bit-trade-one/REVIVE-USB/README.md

# AD00007-REVIVE-USB

## オリジナルUSBデバイスを簡単に作成できるREVIVE USB  
  

USBでパソコンと接続し、専用ソフトウェアを用いて12本のピンに  
任意の操作（マウスクリック／キー入力等）を設定する事が出来ます。 

## [製品の詳細はこちら(BTO_HP)](http://bit-trade-one.co.jp/product/assemblydisk/revive-usb/)

## [キット版組み立て説明書](https://github.com/bit-trade-one/REVIVE-USB/blob/master/Manual/Revive_manual.pdf)  

## [アプリケーションソフト](https://github.com/bit-trade-one/REVIVE-USB/raw/master/App/)  

## [ファームウェア](https://github.com/bit-trade-one/REVIVE-USB/raw/master/FirmWare/)

## [Q&A](https://github.com/bit-trade-one/REVIVE-USB/blob/master/FAQ.md)

### [アプリケーションソース](https://github.com/bit-trade-one/REVIVE-USB/raw/master/App_source/)  

### [ファームウェアソース](https://github.com/bit-trade-one/REVIVE-USB/raw/master/Firmware_source/)

### [基板図](https://github.com/bit-trade-one/REVIVE-USB/blob/master/Dimensions/AD00007_REVIVE_USB_dimensions.pdf)

### [回路図](https://github.com/bit-trade-one/REVIVE-USB/blob/master/Schematics/revive_sch.png)

### [部品表](https://github.com/bit-trade-one/REVIVE-USB/blob/master/Partslist/AD00007-PartsList.md)

## 作例

[\[Bit-trade-one公式\] / 「REVIVE USBを使ってジョイスティックを作成しました！」](http://bit-trade-one-blog.blogspot.com/2012/01/revive-usb.html)  
[\[Bit-trade-one公式\] / 「REVIVE USBを用いたテンキーのショートカットキーボード化」](https://docs.google.com/document/pub?id=1tj2YW0OkGKYTroH0v_psLJJ5uBwOZKFZ7izL9BA2TJg)  
[「味わい尽くせ！ 」様 / 「REVIVE USBをアナログXY軸に対応してみた」](https://gurochoro.blogspot.com/2017/01/revive-usb-infinitas.html)  
[「SEGA至上主義」様 / 「JTKのnProエラーでお困りの方に多ボタンコントローラー自作のススメ」](http://blog.livedoor.jp/sega_ss/archives/12361631.html)  

## 掲載情報

[4Gamer様/「GPUやドライバ，ディスプレイは「ゲームプレイの速度」についていけているのか？ 操作遅延計測用デバイスを開発してみた」](https://www.4gamer.net/games/999/G999902/20171225140/)

## 製品仕様

    製品名：REVIVE USB
    型番：キット版AD00007　/　組立済版　AD00007P
    サイズ：W22×D49mm
    入力点数：12(デジタル)
    コネクタ：シリーズ・ミニB
    対応OS：Windows 10 / 8.1/ 8 / 7 / Vista / XP
    JANコード：キット版　4560196900189 / 組立済版　4560196900394
