bit-trade-one/REVIVE-USB/FirmWare/Readme.md

# ファイルリスト

 - REVIVE_USB_ver008.zip(通常版)
 - REVIVE_MATRIX_ver005.zip(マトリックス版)
 - HIDBootLoader.exe(ファームウェア書込ツール)

# REVIVE USB ファームウェア

REVIVE USB MICROのファームウェアとソースコードを公開しています。  

## HIDブートローダ書き込みソフト（HIDBootLoader.exe）の使い方

### 1. このソフトで何が出来るのか

REVIVE USBはMicrochip社のPICと言うマイコンを用いて作られています。  
通常、PICマイコンにソフトを書き込む為には「ライタ」と呼ばれる書き込み装置が必要です。  
（Microchip社が出しているPICkitや、秋月電子のキットであるAKI-PICプログラマーなどが有名です）  

このソフトを用いれば、特別なライタを必要とせず、USBから直接マイコンのソフトを書き換える事ができます。  
ただし、その為にはマイコンにBootLoaderと呼ばれる特別なソフトがあらかじめ書き込まれている必要があり、またUSB経由で書き込むソフトもBootLoaderに対応したものになっていなければなりません。  
あらかじめ書き込まれるBootLoader自体は、「ライタ」で書き込まなければなりません。  

REVIVE USBに付属しているマイコンにはこのBootLoaderと言う特別なソフトがあらかじめ書かれています。よって、特別なライタをお持ちでなくてもUSB経由でソフトを書き込むことができます。  
また、Assembly Deskで公開されているREVIVE USB用のソフトはこのBootLoaderでの書き込みに対応したソフトになっています。  

このBootLoaderを使うことで、USB経由で簡単にソフトを書き換えて、REVIVE USBのソフトを様々に書き換える事ができます。  

### 2. 準備

Assembly DeskのサイトからHIDBootLoader.exeをダウンロードします。  
（これは、Microchipさんが公開しているライブラリ「MCHPFSUSB」の中にある物と同一です）  

このソフトは.NET framework 2.0を用いて作成されています。  
お手持ちのパソコンに.NET frameworkがインストールされていない場合、MicrosoftさんのHPからこれらをダウンロードし、インストールしておく必要があります。  
“Microsoft .NET framework”等のキーワードで検索すると出てきます。  

書き込みたいソフトもダウンロードしておきます。  

### 3. ソフトの書き込み

HIDBootLoader.exeを立ち上げます。  
  
次に、REVIVE USBのショートピンをBOOTに設定し、USBケーブルを接続します。  
（REVIVE USBが既に差し込んであった場合には一度抜いてからショートピンをBOOTに変更し、再度USBケーブルを差し込みます）  
  
ショートピンをBOOTの方にし、USB ケーブルを接続します。  
  
デバイスが認識されると上図の様に「Device attached」と表示されます。  
この表示が出たら「上」ボタンは離しても大丈夫です。  
始めてBOOTモードで接続した時には、自動的にPCにドライバがインストールされます。（約１分程時間かかります）  

「Open Hex File」を押します。  
書き込みたいHexファイルを選択します。  
  
「Program/Verify」を押します。  
ソフトが書き込まれます。  
  
ショートピンを通常状態に戻し、USBケーブルを抜き差しするか、「Reset Device」を押すと、書き込んだソフトが起動します。
