bit-trade-one/REVIVE-USB/Firmware_source/Readme.md

# ファイルリスト

 - ReviveUSB_FWver008.zip(通常版)
 - MatrixVer005.zip(マトリックス版)

# REVIVE USBファームウェアソースコード

このファームウェアは以下の環境で開発しています。
 - MPLAB  IDE           v8.92
 - MPLIB  Librarian     v5.00
 - MPLAB  C18 Compiler  v3.47
 - MPLINK Object Linker v5.00
 - MPASM  Assembler     v5.54
