bit-trade-one/REVIVE-USB/App_source/Readme.md

# ファイルリスト

 - ReviveUSB_CTsrc_ver130.zip(通常版)
 - PCMatrix_v111.zip(マトリックス版)
 
# REVIVE USB 設定ツール開発環境

このソフトウェアは、以下の環境で開発されています。
- Microsoft Visual C# 2010 Express
