bit-trade-one/REVIVE-USB/Schematics/revive_sch.png

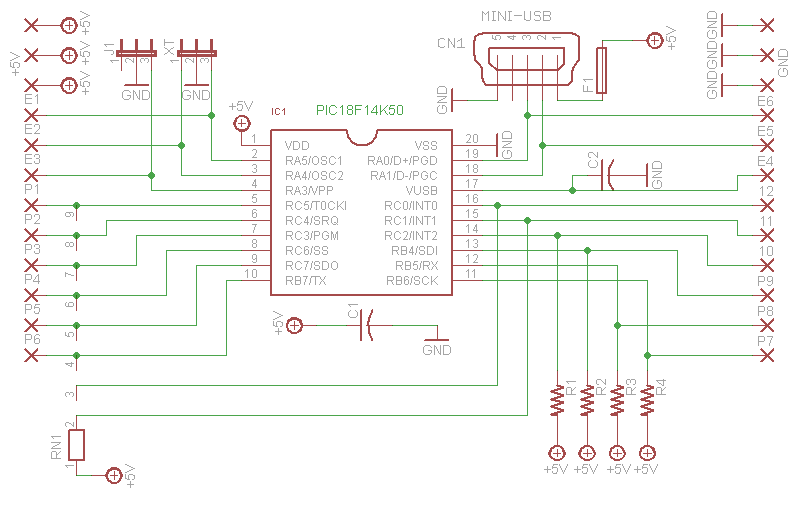
Schematics/revive_sch.png
