bit-trade-one/REVIVE-USB/Partslist/AD00007-PartsList.md

|記号|品名|型式|値|備考|
|:-|:-|:-|:-|:-|
|C1|セラミックコンデンサ||0.1uF|104と印字|
|C2|セラミックコンデンサ||0.1uF|104と印字|
|CN1|USB コネクタ|||ミニB|
|R1|抵抗||1kΩ|茶 黒 赤 金|
|R2|抵抗||1kΩ|茶 黒 赤 金|
|R3|抵抗||1kΩ|茶 黒 赤 金|
|R4|抵抗||1kΩ|茶 黒 赤 金|
|RN1|集合抵抗|RKL8BD-102J|1kΩ|向きに注意|
|X1|セラミック発振子||12MHz||
|F1|ポリスイッチ|RXEF017|0.17A||
|IC1|ICソケット||20ピン|向きに注意|
|IC1|マイコン|PIC18F14K50||向きに注意|
||基板||||
||ヘッダピン||12ピン|2ヶ|
||ヘッダピン||3ピン||
||ショートピン||||
||貼付けボス|ASR-6||2ヶ|
||タッピングネジ|3×6||2ヶ|
