bit-trade-one/REVIVE-USB/Dimensions/AD00007_REVIVE_USB_dimensions.pdf

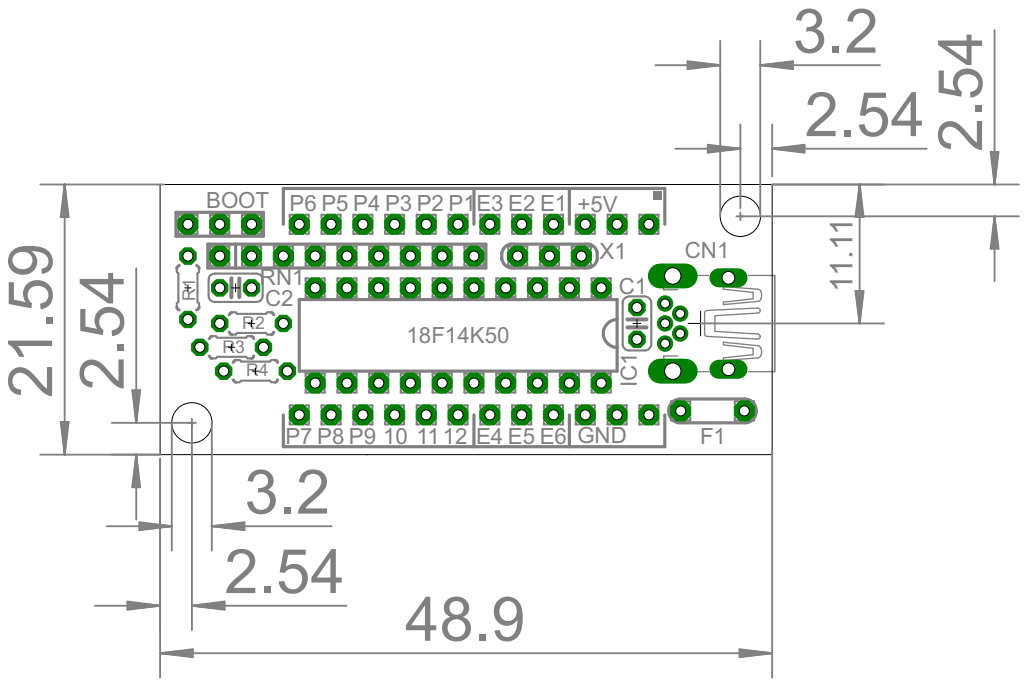
[picture p2: page 1]
