bit-trade-one/REVIVE-USB/Manual/Revive_manual.pdf

# 【 リヴァイヴ USB 】

## 〈 キット作成方法・使用方法 〉

2010/10/21 *ver1.00

(http://a-desk.jp/)

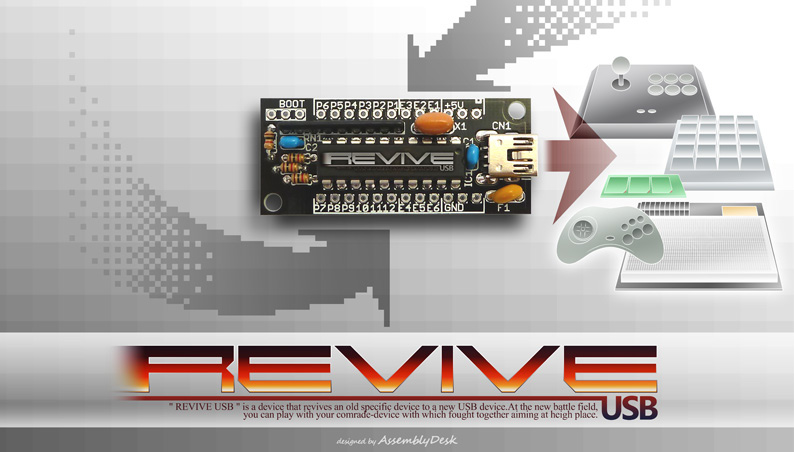
[picture p3: figure]

本文書は Assembly Desk で設計された REVIVE USB の使用方法（A 項）とキット作成（B 項）の マニュアルです。本キットに関する詳細資料は以下のサイトをご参照下さい。

http://a-desk.jp/modules/forum_module/index.php?cat_id=3
任意にボタンの動作を変えられるアプリケーション [REVIVE USB ConfigurationTool] の ダウンロードや、デバイス別の接続手順ドキュメントなどがリンクしてあります。

概要

(CreationDate 2010/10/21)
Assembly Desk

A: ミニ B タイプの USB ケーブルを用いて PC と REVIVE USB を接続します。 （A: ミニ B タイプの USB ケーブルは別売となります）

接続後、自動的に PC が REVIVE USB を認識します。

（初めて REVIVE USB を接続する時や、
挿し込む USB ポートを変えた時には、
認識までに１分ほどの時間がかかる事があります）

接続が完了すると REVIVE USB は「マウス」 「キーボード」「ゲームコントローラ」の
複合デバイスとして認識されます。

## A-1 . 使用方法～ PC との接続

A: ミニ B タイプの USB ケーブルを用いて PC と REVIVE USB を接続します。
（A: ミニ B タイプの USB ケーブルは別売となります）
[REVIVE USB をスイッチへ繋ぐ場合 ]
P1 ～ P12（ピン）をそれぞれのスイッチの片方へ。スイッチのもう一端は全てまとめて GND（グランド）へ繋ぎます。（GND を４つずつ位にまとめると配線し易くなります）

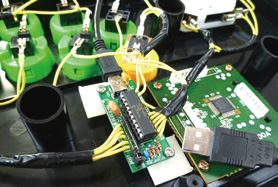
[picture p4: figure]

[REVIVE USB をマイコンへ繋ぐ場合 ]
マイコンのポートを出力に設定し、REVIVE USB の P1 ～ P12 のいずれかと 直接繋いでください。
また、REVIVE USB の「+5V」ピンには USB 電源が来ていますので、5V 電源として 使用する事が出来ます。REVIVE USB とマイコンの GND は共通にしておいてください。

## A-2 . 使用方法～各種デバイスとの接続方法

( ゲームスティックとの接続例 )

## A-3. 使用方法～ REVIVE USB ConfigurationTool の使い方

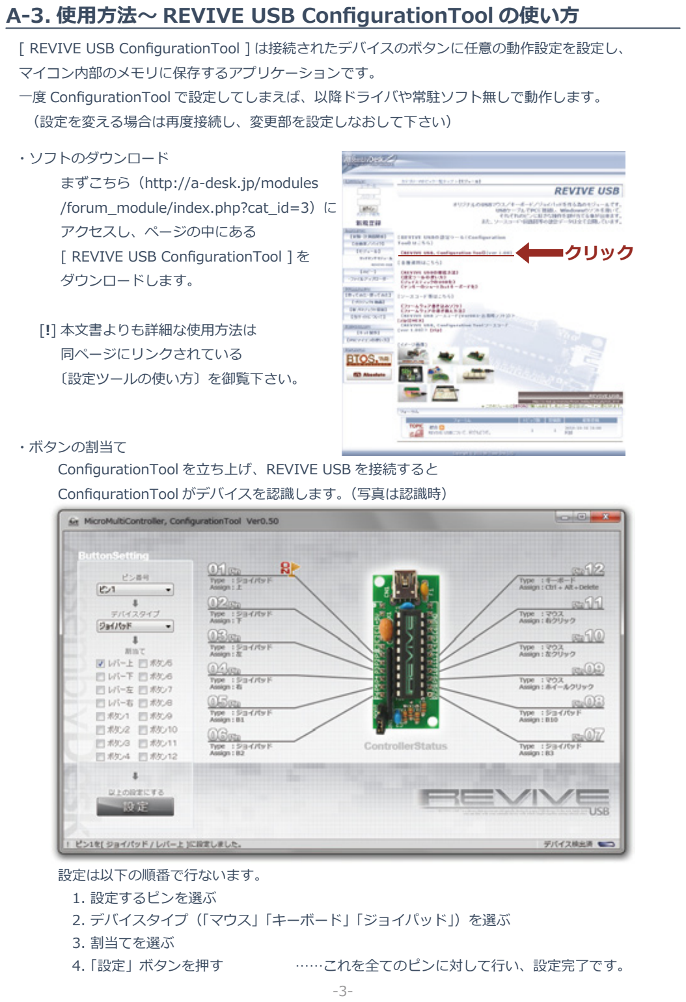
[picture p5: page 3]

[ REVIVE USB ConfigurationTool ] は接続されたデバイスのボタンに任意の動作設定を設定し、 マイコン内部のメモリに保存するアプリケーションです。
一度 ConfigurationTool で設定してしまえば、以降ドライバや常駐ソフト無しで動作します。 （設定を変える場合は再度接続し、変更部を設定しなおして下さい） ・ソフトのダウンロード
まずこちら（http://a-desk.jp/modules/forum_module/index.php?cat_id=3）に アクセスし、ページの中にある
[ REVIVE USB ConfigurationTool ] を ダウンロードします。

本文書よりも詳細な使用方法は
同ページにリンクされている
〔設定ツールの使い方〕を御覧下さい。

[!]

・ボタンの割当て
ConfigurationTool を立ち上げ、REVIVE USB を接続すると ConfigurationTool がデバイスを認識します。（写真は認識時）

……これを全てのピンに対して行い、設定完了です。

設定は以下の順番で行ないます。
1. 設定するピンを選ぶ
2. デバイスタイプ（「マウス」「キーボード」「ジョイパッド」）を選ぶ
3. 割当てを選ぶ
4. 「設定」ボタンを押す

### クリック

## B-1 . 作成の前に～内容物の確認と道具の準備

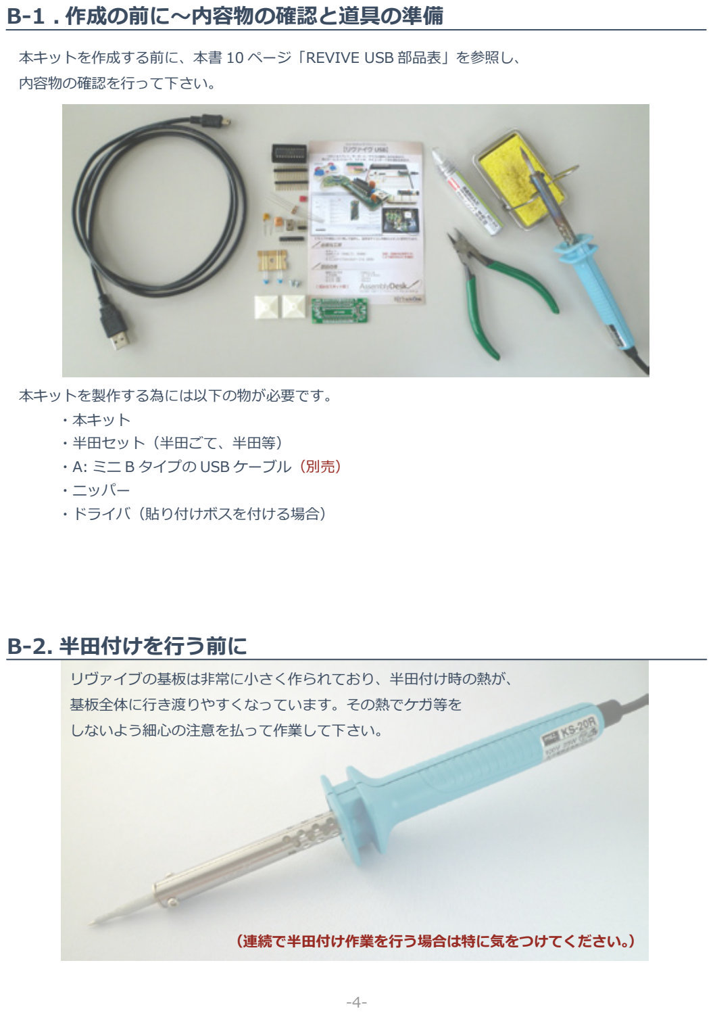
[picture p6: page 4]

リヴァイブの基板は非常に小さく作られており、半田付け時の熱が、 基板全体に行き渡りやすくなっています。その熱でケガ等を しないよう細心の注意を払って作業して下さい。

## B-2. 半田付けを行う前に

（連続で半田付け作業を行う場合は特に気をつけてください。）

本キットを製作する為には以下の物が必要です。
・本キット
・半田セット（半田ごて、半田等）
・A: ミニ B タイプの USB ケーブル（別売） ・ニッパー
・ドライバ（貼り付けボスを付ける場合）

本キットを作成する前に、本書 10 ページ「REVIVE USB 部品表」を参照し、 内容物の確認を行って下さい。

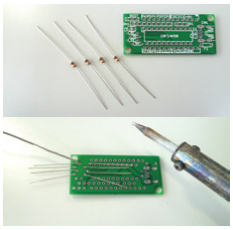
[picture p7: figure]

3-1 「抵抗の取り付け」
・半田付けは背の低いものから順に行うと
作業が楽になります。そこでまず、
基板の表（白いシルク印刷がある面）に
抵抗を取り付けます。R1 ～ R4 に
1kΩ（茶黒赤金）の抵抗を取り付けます。

向きはありませんが、抵抗の色コードの
向きを合わせておくと
見た目が良くなります。

## B-3. キット工作～ REVIVE USB の作成

3-2 「USB コネクタの取り付け」
・USB コネクタを取り付けます。

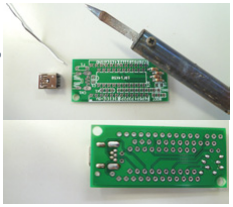
[picture p8: figure]

5 ヵ所のピンだけではなく、周りの 4 ヶ所の
大きな穴の部分も半田付けをします。

ピンの部分は間隔が狭くなっているので、
注意して半田付けしてください。

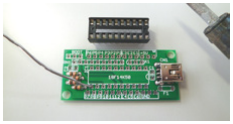
[picture p9: figure]

3-3 「IC ソケットの取り付け」
・IC1 にソケットの凹みがシルク印刷と
合う向きにして、IC ソケットの
半田付けを行ないます。

なお、背を低く作るために IC ソケットの
取り付けを省略する場合は、
ここでマイコンを直接半田付けします。
（マイコンは熱に弱いので、
加熱しすぎ無いよう気をつけてください。）

## B-3. キット工作～ REVIVE USB の作成（続き）

3-4 「コンデンサ C1 ／ C2 の取り付け」
・マイコンを間にして離れている C1/C2 に
セラミックコンデンサを取り付けます。
（104 と書かれています）

3-5 「集合抵抗の取り付け（向きに注意）」

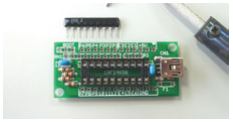
[picture p10: figure]

・RN1 に集合抵抗（102J と書かれています）
の白い点が付いている方を、
シルクの一つだけ分かれている方に
合わせて取り付けます。

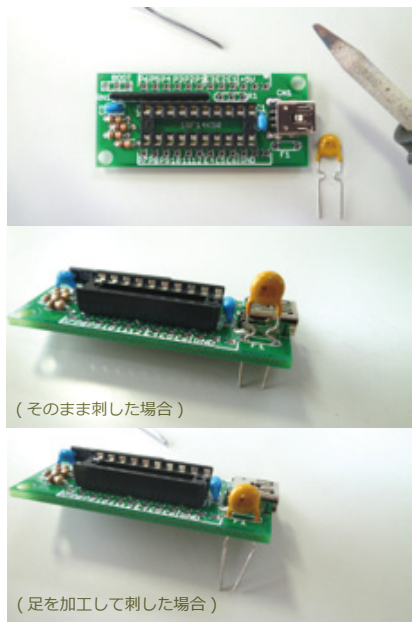
[picture p11: figure]
( そのまま刺した場合 ); ( 足を加工して刺した場合 )

3-6 「ポリスイッチの取り付け」
・F1 にポリスイッチ
(XF017 と書かれています ) を
取り付けます。

ポリスイッチは電流が流れすぎた時に
回路を遮断する保護素子です。

## B-3. キット工作～ Revive USB の作成（続き）

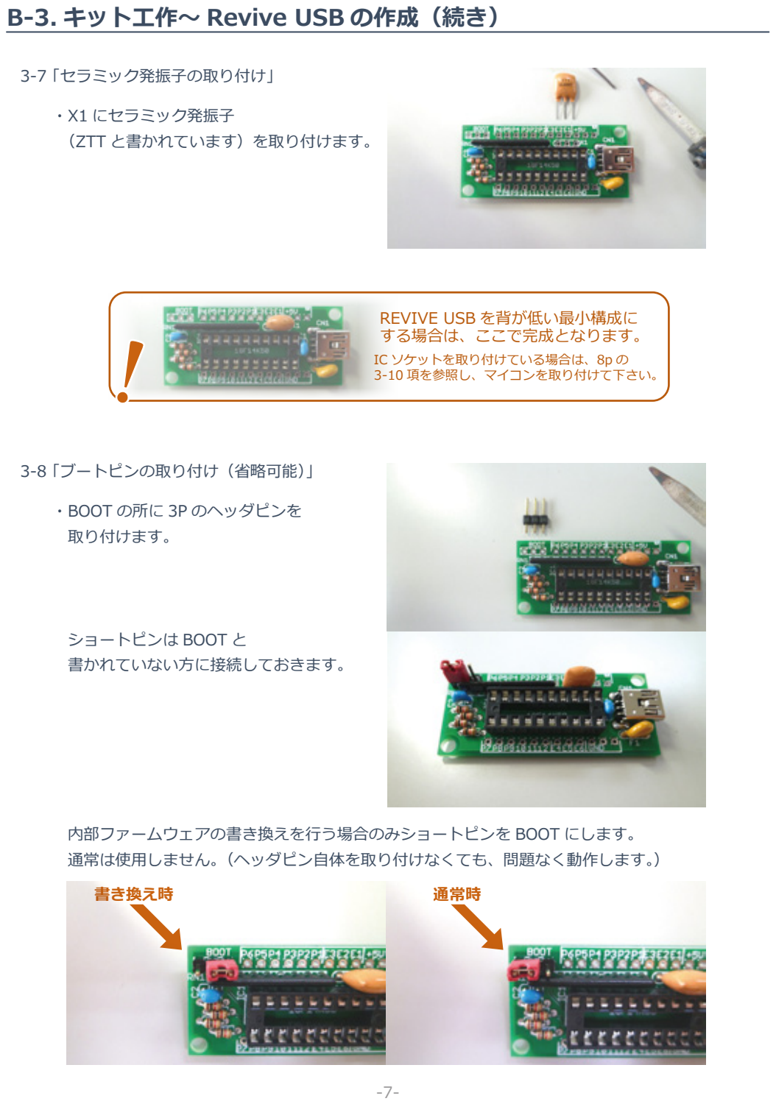
[picture p12: page 7]

3-7 「セラミック発振子の取り付け」
・X1 にセラミック発振子
（ZTT と書かれています）を取り付けます。

3-8 「ブートピンの取り付け（省略可能）」
・BOOT の所に 3P のヘッダピンを
取り付けます。

ショートピンは BOOT と
書かれていない方に接続しておきます。

内部ファームウェアの書き換えを行う場合のみショートピンを BOOT にします。 通常は使用しません。（ヘッダピン自体を取り付けなくても、問題なく動作します。）

REVIVE USB を背が低い最小構成に
する場合は、ここで完成となります。
IC ソケットを取り付けている場合は、8p の
3-10 項を参照し、マイコンを取り付けて下さい。
書き換え時 | 通常時

## B-3. キット工作～ REVIVE USB の作成（続き）

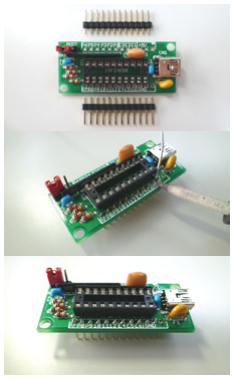
[picture p13: figure]

3-9 「ピンの取り付け（省略可能）」
・必要であれば、24 ピンヘッダピンを
取り付けます。
（ピンとピンの間隔が非常に狭いので
注意して作業してください。）

上面が短い方で底面が
長くなるようにして取り付けて下さい。

ヘッダピンを取り付けると、
IC ソケットや、ブレッドボードを
使用できるようになります。

3-10 「マイコンの取り付け」
・マイコンを IC ソケットに取り付けます。
マイコンと IC ソケットの凹みの向きを
合わせて取り付けます。

マイコンは少し足が広がった状態と
なっているので、少し足を狭めてから

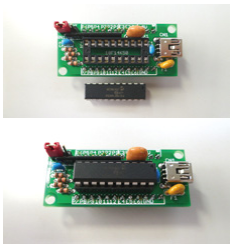
[picture p14: figure]

取り付けると楽に取り付ける事が出来ます。

## B-3. キット工作～ REVIVE USB の作成（続き）

3-11 「貼り付けボスの取り付け」
・REVIVE USB をどこかに貼り付けて
使用したい場合には、
貼り付けボスが便利です。
貼り付けボスにタッピングビスを
利用して基板を付けます。

貼り付けボスの両面テープを剥がして、貼り付けたい場所に貼り付けます。 ビス及び貼り付けボスの両面テープは再使用には向きません。

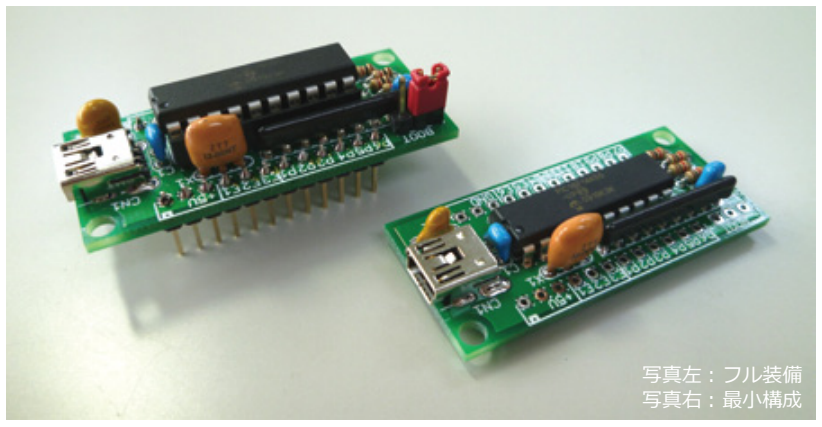
[picture p15: figure]
写真左 : フル装備 写真右 : 最小構成

今度は ConfigurationTool を用いて様々な USB デバイスを作成してみましょう！！ お疲れ様でした！

これで REVIVE USB の完成です。

## REVIVE USB 部品表

記号 | 品名 | 型式 | 値 | 備考
C1 | セラミックコンデンサ | | 0.1μF | 104と印字
C2 | セラミックコンデンサ | | 0.1μF | 104と印字
CN1 | USBコネクタ | | | ミニB
R1 | 抵抗 | | 1kΩ （茶黒赤金）
R2 | 抵抗 | | 1kΩ （茶黒赤金）
R3 | 抵抗 | | 1kΩ （茶黒赤金）
R4 | 抵抗 | | 1kΩ （茶黒赤金）
RN1 | 集合抵抗 | RKL8BD-102J | 1kΩ | 向きに注意
X1 | セラミック発振子 | | 12MHz
F1 | ポリスイッチ | RXEF017 | 0.17A
IC1 | ICソケット | | 20ピン | 向きに注意
IC1 | マイコン | PIC18F14K50 | | 向きに注意
| 基板
| ヘッダピン | | 12ピン | 2ヶ
| ヘッダピン | | 3ピン
| ショートピン
| 貼付けボス | ASR-6 | | 2ヶ
| タッピングネジ | 3×6 | | 2ヶ

## Memo

## Memo
