bit-trade-one/REVIVE-USB/FAQ.md

# REVIVE USB よくある質問

## Q.照光式ボタンに接続したいのですが、どのように接続したらランプが点灯しますでしょうか？

### A.以下の回路を参照下さい
動作の保証はいたしかねますが、ボタンを押している間点灯する回路として、REVIVE USBより5V、GND、スイッチ接続端子Px(xは1~12のポート)を引き出し、
以下のように接続する例が考えられます。
抵抗Rの値につきましてはスイッチの仕様に合わせた値を選定下さい。

----

## Q: 1回路のスイッチに対しREVIVEを二台使い、二重化したい。(同時に複数のデバイスへ入力を行いたい)

### A：リレー等を使用しそれぞれを絶縁してお使いください。
参考回路を掲載しますが、動作の保証は致しかねます。



----
