bit-trade-one/REVIVE-USB/(commit log)

2021-09-08 Update FAQ.md
    1回路のスイッチに対しREVIVEを二台使い、二重化したい。(同時に複数のデバイスへ入力を行いたい)を追加
2021-10-14 Update Readme.md
    ushui殿作成FWを追加
2021-11-02 Add files via upload
    抜けていたREVIVE_USB_v100_PID6E.zipを追加
2021-11-05 Update Readme.md
    ushui殿作成FWのご紹介
2021-11-05 Create Readme.md
    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
2021-11-05 Update Readme.md
    ushui殿作成FW・設定ツールのご紹介 の追加
2021-11-08 Update Readme.md
    ロータリエンコーダ群の説明削除
2021-11-24 Update README.md
    Q&Aを追加
    〇〇はこちらを削除
